rtitmuss/torn/(notices)

Notices in the files:
case/PCB Case/base/torn_base.kicad_pcb:
Torn keyboard is licensed under CC BY-NC 4.0
torn_left/torn_left.kicad_pcb:
Torn keyboard licensed under CC BY-NC 4.0
